Tuteku/Sistema-de-Monitoreo-de-CO-en-Tiempo-Real-con-LPC1769-ARM-Cortex-M3-/.mcuxpressoide_packages_support/readme.txt

This folder is automatically created and contains the SDK part support for the IDE
*** DO NOT REMOVE OR MODIFY, YOUR CHANGES WILL BE OVERWRITTEN ON SDK REFRESH ***
