Tuteku/Sistema-de-Monitoreo-de-CO-en-Tiempo-Real-con-LPC1769-ARM-Cortex-M3-/Grup_5_TPI_EDIII.pdf

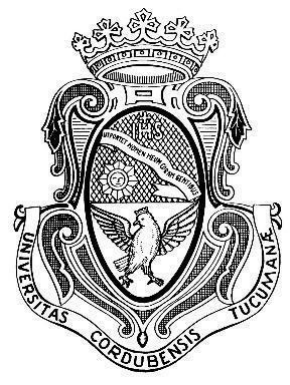
[picture p1: figure]

## UNIVERSIDAD NACIONAL DE CÓRDOBA

### FACULTAD DE CIENCIAS EXACTAS, FÍSICAS Y NATURALES

### CÁTEDRA DE ELECTRÓNICA DIGITAL III

## TRABAJO PRÁCTICO INTEGRADOR

## “SISTEMA DE DETECCIÓN DE ANOMALÍAS EN NIVELES DE MONÓXIDO DE CARBONO”

### Grupo Nº 5

### Alumnos: Costamagna, Matias

### de la Mata, Nicolas

### Quispe, Mateo

### Profesor:

### Migliore, Emiliano

### Comisión Nº 3

18/11/2025

### TABLA DE CONTENIDO

### 1. PROYECTO 2. DESCRIPCIÓN DEL SEP 3. DESARROLLO DE HARDWARE

CIRCUITO DEL SSEP MICROCONTROLADOR CIRCUITO DEL SSE DE SEÑALIZACIÓN ÓPTICA CIRCUITO DEL SSE DE SEÑALIZACIÓN ACÚSTICA CIRCUITO DEL SSE DE ADQUISICIÓN DE SEÑALES CIRCUITO DEL SSE DE COMUNICACIÓN DE DATOS CIRCUITO DEL SSE DE VISUALIZACIÓN DE DATOS

### 4. DESARROLLO DE FIRMWARE

FIRMWARE DEL SSE DE SEÑALIZACIÓN ÓPTICA FIRMWARE DEL SSE DE SEÑALIZACIÓN ACÚSTICA
FIRMWARE DEL SSE DE VISUALIZACIÓN DE DATOS
FIRMWARE DEL SSE DE ADQUISICIÓN DE SEÑALES
FIRMWARE DEL SSE DE COMUNICACIÓN DE DATOS

### 5. PRUEBAS DE SISTEMA 6. CONCLUSIONES 7. BIBLIOGRAFÍA Y REFERENCIAS 8. ANEXO

CIRCUITO ESQUEMÁTICO DEL SEP FIRMWARE DEL SEP LPC1769
FIRMWARE DEL SEP ESP8266
LISTA DE MATERIALES
HOJAS DE DATOS

### TÉRMINOS Y DEFINICIONES

TPI: Trabajo Práctico Integrador
SEP: Sistema Electrónico Programable SSE: Subsistema Electrónico
SSEP: Subsistema Electrónico Programable

### 1. PROYECTO

El presente Trabajo Práctico Integrador describe la implementación de un "SISTEMA DE DETECCIÓN DE ANOMALÍAS EN NIVELES DE MONÓXIDO DE CARBONO" destinado a la detección temprana y precisa de concentraciones peligrosas de monóxido de carbono (CO) en ambientes domésticos e industriales.

El sistema se basa en un LPC1769 como microcontrolador principal, el cual adquiere señales analógicas por medio de un sensor de gas MQ-7 especializado en la detección de monóxido de carbono para luego ser procesadas digitalmente. El resultado del análisis permite determinar la concentración de CO en el ambiente, expresada en PPM (partes por millón).

El sistema cuenta con múltiples interfaces de visualización y alerta: un sistema de señalización óptica mediante LEDs de colores que indican visualmente el nivel de peligro (verde: seguro, amarillo: precaución, rojo: peligro crítico), un sistema de señalización acústica mediante buzzer que genera alertas sonoras intermitentes en condiciones críticas, y una interfaz web accesible mediante WiFi a través del módulo ESP8266 que presenta los datos de concentración de CO en tiempo real.

La detección de monóxido de carbono se realiza mediante un sensor MQ-7, el cual posee alta sensibilidad al CO y baja sensibilidad a otros gases.

El sistema implementa además un mecanismo de confirmación de alarma crítica mediante la acumulación de múltiples lecturas consecutivas por encima del umbral, evitando falsas alarmas por picos momentáneos de concentración.

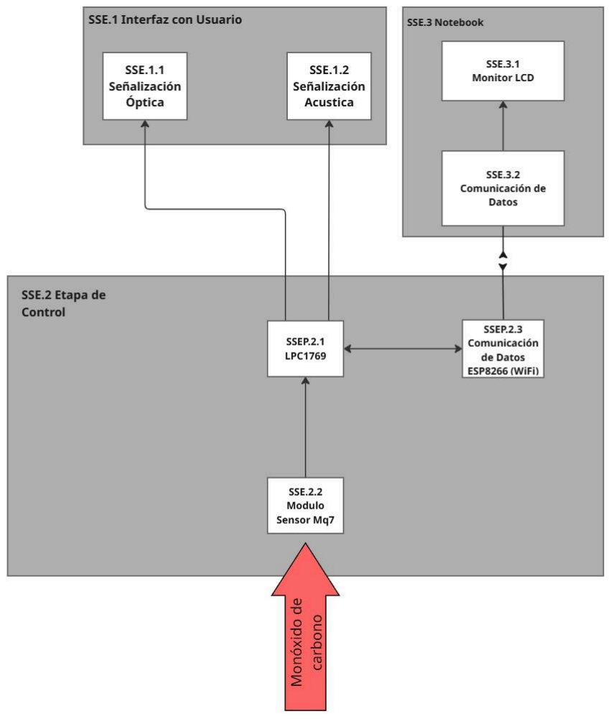
[picture p2: figure]

### 2.DESCRIPCIÓN DEL SEP

El sistema desarrollado consiste en un detector de monóxido de carbono automático basado en el microcontrolador LPC1769, diseñado para monitorear continuamente la concentración de CO en el ambiente mediante un sensor MQ-7. Cuando se detectan niveles peligrosos de gas, el sistema activa alarmas visuales y sonoras de forma progresiva según la gravedad de la situación.

El sistema opera de manera autónoma realizando mediciones periódicas cada 1 [s]. Las lecturas del sensor se procesan mediante el módulo ADC interno del LPC1769, convirtiendo las señales analógicas en valores digitales que representan la concentración de CO en [mV]. Estos valores se utilizan para determinar el estado de alerta del sistema según umbrales configurables: estado seguro (LED verde), estado de precaución (LED amarillo) y estado crítico (LED rojo con alarma sonora).

El usuario recibe información del sistema a través de múltiples interfaces: señalización óptica mediante tres LEDs de colores que indican el nivel de peligro, señalización acústica mediante un buzzer que se activa en situaciones críticas generando un tono de alerta, y transmisión de datos por comunicación serial UART hacia un módulo ESP8266 para visualización remota. Las señales adquiridas del sensor MQ-7 son procesadas por el ADC y distribuidas a los distintos subsistemas: control de alarmas, señalización óptica, señalización acústica y comunicación de datos.

El sistema implementa lógica de histéresis para evitar falsas alarmas, requiriendo múltiples lecturas consecutivas por encima del umbral de precaución antes de activar el estado crítico. Esta característica garantiza mayor confiabilidad en la detección, reduciendo activaciones espurias por variaciones momentáneas en la concentración de gas.

### 3. DESARROLLO DE HARDWARE

### 3.1. CIRCUITO DEL SSEP MICROCONTROLADOR

El subsistema electrónico programable central se basa en el microcontrolador LPC1769 de NXP, un dispositivo de 32 bits con arquitectura ARM Cortex-M3 que opera a una frecuencia de 100 [MHz]. Para el clock el sistema utiliza el oscilador RC interno del LPC1769 para generar la señal de reloj del sistema.

El microcontrolador utiliza los siguientes pines para interactuar con los distintos subsistemas:

- P0.23 (AD0.0): Entrada analógica para la lectura del sensor MQ-7, configurada con función alterna 1 para el canal 0 del ADC.
- P1.29 (MAT0.1): Salida del canal de Match 0 del Timer 0, configurada para generar los pulsos de disparo del ADC.
- P0.10 (TXD2): Transmisión UART2, para la comunicación serial con el módulo ESP8266.
- P0.2, P0.3, P0.27: Salidas GPIO configuradas para control de LEDs (rojo, amarillo y verde respectivamente).
- P0.22: Salida GPIO configurada para control del buzzer.

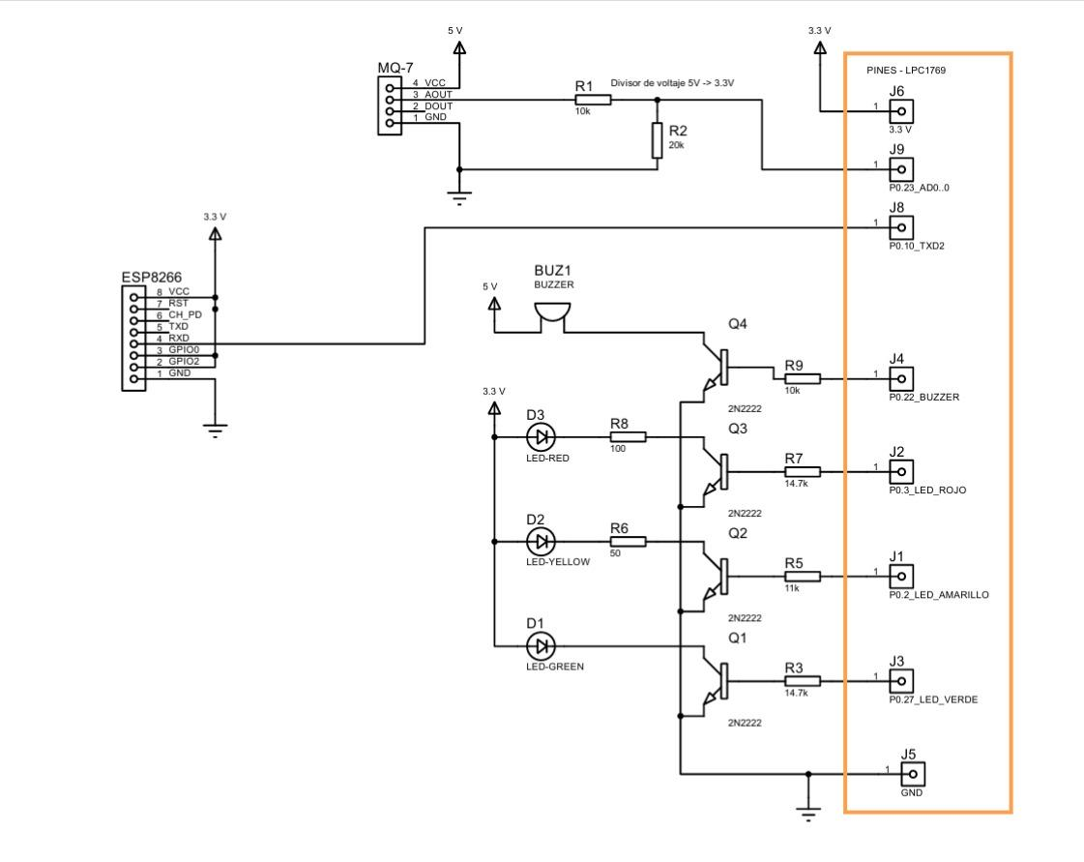
[picture p3: figure]

### 3.2. CIRCUITO DEL SSE DE SEÑALIZACIÓN ÓPTICA

El subsistema de señalización óptica proporciona retroalimentación visual inmediata al usuario sobre el estado de la concentración de monóxido de carbono detectada en el ambiente. Este subsistema utiliza tres LEDs de colores estándar (verde, amarillo y rojo) que indican de manera visual e intuitiva los diferentes niveles de alerta del sistema.

Componentes Utilizados:

- LED Verde D1 (P0.27): Indica estado seguro, con concentración de CO por debajo del umbral de precaución.
- LED Amarillo D2 (P0.3): Indica estado de precaución, con concentración de CO mayor al umbral de precaución.
- LED Rojo D3 (P0.2): Indica estado crítico, con concentración de CO por encima del umbral de precaución sostenida en el tiempo.

Dado que los pines GPIO del LPC1769 tienen una capacidad limitada de corriente (máximo 2.58 [mA] para el periférico GPIO), y considerando que los LEDs estándar requieren típicamente 15-20 [mA] para una luminosidad adecuada, se implementó un circuito mediante transistores NPN 2N2222A para cada LED.

R

LED R =

V

CC−V

LED R−V
CE(sat)
I
LED

=

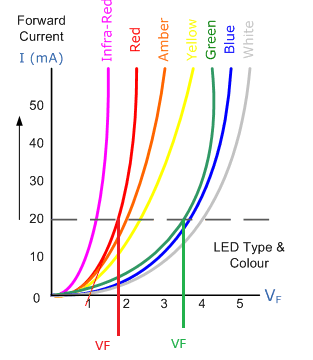
[picture p4: figure]

3.3 [V]−1.5 [V]−0.3 [V]
15 [mA] = 93. 33 [Ω] ≈ 100 [Ω]

R

LED V =

V

CC−V

LED V−V
CE(sat)
I
LED

=

3.3 [V]−3 [V]−0.3 [V]
15 [mA] = 0 [Ω] −> No es necesaria

R

LED A =

V

CC−V

LED A −V
CE(sat)
I
LED

=

3.3 [V]−2 [V]−0.3 [V]
15 [mA] = 66, 67 [Ω] ≈ 50 [Ω]

I

LED A =

V

CC−V

LED A−V
CE(sat)
R
LED A

=

3.3 [V]−2 [V]−0.3 [V]
50 [Ω] = 20 [mA]

R

base =

V

OH−V
BE
I
B

=

(V

DD−0.4 [V])−V
BE
I
C
/ β | =

(3.3 [V]−0.4 [V])−0.7 [V]
15 [mA] / 100 = 14. 67 [kΩ] ≈ 14. 7 [kΩ]

R

base LED A =

V

OH−V
BE
I
B

=

(V

DD−0.4 [V])−V
BE
I
C
/ β | =

(3.3 [V]−0.4 [V])−0.7 [V]
20 [mA] / 100 | = 11 [kΩ]
1. Alimentación de los LEDs: Los ánodos de todos los LEDs se conectan directamente a la línea de alimentación de 3.3 [V].
2. Resistencias limitadoras de corriente (R4, R6, R8): Los LEDs rojo y amarillo cuentan con una resistencia en serie de 100 [Ω] y 50 [Ω] respectivamente conectadas entre el cátodo de cada LED y el colector del transistor 2N2222A, . Estas resistencias limitan la corriente que circula por los LEDs.
3. Transistores (Q1, Q2, Q3): Se utilizan transistores NPN 2N2222A configurados como interruptores en configuración de emisor común. El colector de cada transistor se conecta al cátodo del LED correspondiente a través de la resistencia limitadora, mientras que el emisor se conecta directamente a tierra (GND).
4. Resistencias de base (R3, R5, R7): Cada transistor cuenta con una resistencia de base de 14.7 [kΩ] (11 [kΩ] para el LED amarillo) conectada entre el pin GPIO del microcontrolador y la base del transistor. Estas resistencias limitan la corriente de base y protegen el pin GPIO del microcontrolador.

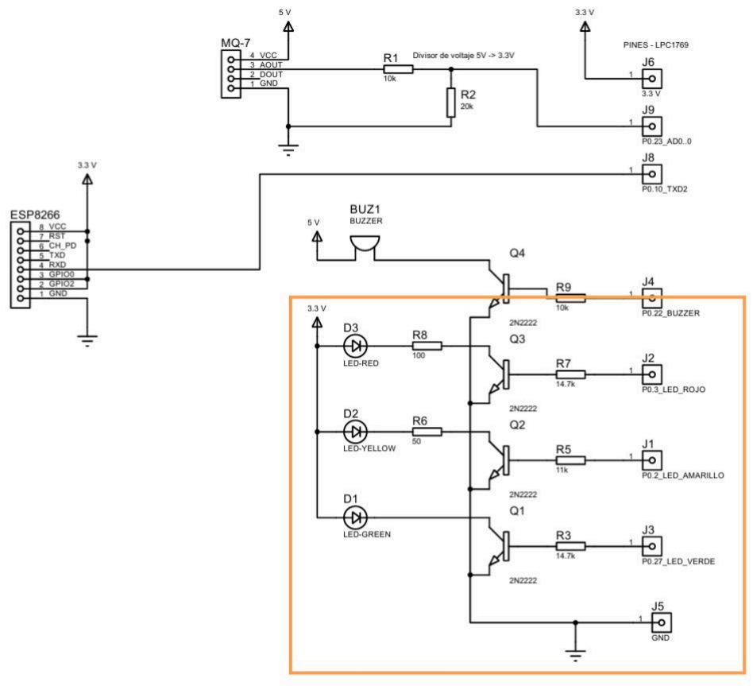
[picture p5: figure]

### 3.3. CIRCUITO DEL SSE DE SEÑALIZACIÓN ACÚSTICA

El subsistema de señalización acústica proporciona una alerta sonora cuando el sistema alcanza el estado crítico. Este subsistema complementa la señalización visual, generando una advertencia audible que permite al usuario ser alertado incluso cuando no está observando directamente los indicadores LED.

Componente Utilizado:

- Buzzer (P0.22): Transductor piezoeléctrico, o buzzer activo, que genera una señal sonora intermitente durante el estado de alarma crítica.

Circuito de Interfaz:

Similar al subsistema de señalización óptica, el buzzer requiere una tensión de alimentación que excede la tensión máxima de suministro del LPC1769 (3.3 [V]). Por esta razón, se implementó un circuito el cual se habilita mediante un transistor NPN 2N2222A que actúa como interruptor.

Datos:

- VCC = 5 [V]
- VBUZZER = 5 [V] (caída de voltaje típica del buzzer piezoeléctrico)
- VBE = 0.7 [V] (voltaje base-emisor del 2N2222A)
- VCE saturación = 0.4 [V]
- β = 100
- Corriente de consumo máximo del Buzzer = 30 [mA] = IC max

I

B max =

I
C max
β | = V OH−V
| BE
| R
| B min

R

B min = β ·

V

OH−V
BE
I
C

= 100 ·

(V

DD−0.4 [V] ) − 0.7 [V]
30 [mA] = 7. 33 [kΩ] −> Se elige 10 [kΩ]

Debido a que el buzzer genera una caída de tensión de 5V, es necesario alimentarlo con una fuente de tensión externa de ese valor. Además, resulta que no es necesario colocar una resistencia en el colector del transistor, pues la caída de tensión entre el colector y el emisor es menor que la VCE de saturación, lo que nos mantiene en esa zona de operación del transistor.

De esta forma, el buzzer se encenderá cada vez que la salida del pin conectado en la base se encuentre en un nivel lógico “1” generando así la caída de tensión necesaria entre la base y el emisor que habilite el paso de la corriente del colector, funcionando como un switch.

1. Alimentación del buzzer: El terminal positivo del buzzer se conecta directamente a la línea de alimentación de 5 [V].
2. Transistor (Q4): Transistor NPN 2N2222A configurado como interruptor. El colector se conecta al terminal negativo del buzzer, mientras que el emisor se conecta directamente a tierra (GND).
3. Resistencia de base (R9): Una resistencia de 10 [kΩ] conectada entre el pin P0.22 del microcontrolador y la base del transistor Q4. Esta resistencia limita la corriente de base a 0.22 [mA].

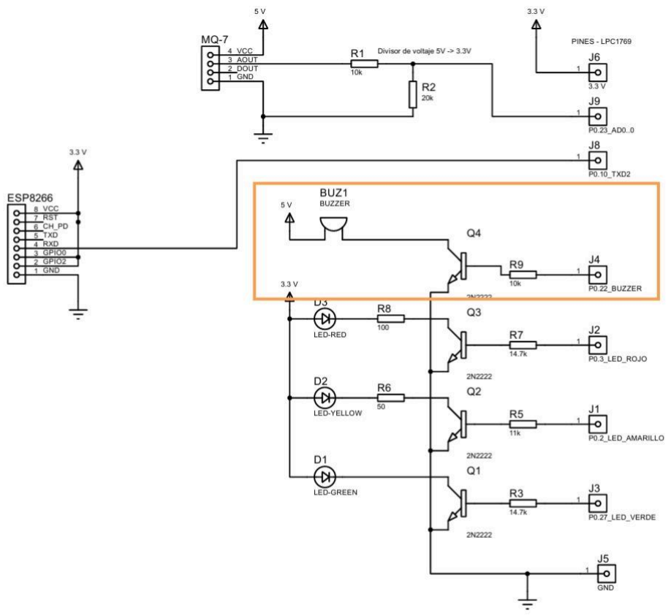
[picture p6: figure]

### 3.4. CIRCUITO DEL SSE DE ADQUISICIÓN DE SEÑALES

El subsistema de adquisición de señales es el componente sensorial del sistema, responsable de detectar la presencia y concentración de monóxido de carbono en el ambiente. Este subsistema utiliza el sensor de gas MQ-7, capaz de detectar concentraciones en el rango de 20 a 2000 [ppm]. El sensor MQ-7 requiere una alimentación de 5 [V] para su correcto funcionamiento. Esta tensión se obtiene directamente de la línea de 5 [V] del puerto USB de la computadora.

La salida analógica del sensor MQ-7 proporciona un voltaje proporcional a la concentración de CO detectada, con un rango típico de 0 a 5 [V]. Sin embargo, el conversor analógico-digital (ADC) del microcontrolador LPC1769 acepta señales de entrada con un rango dinámico comprendido entre 0 y 3.3 [V]. Aplicar voltajes superiores a 3.3 [V] en el pin del ADC podría dañar permanentemente el microcontrolador.

Para resolver esta incompatibilidad, se implementó un circuito divisor resistivo que escala proporcionalmente el voltaje de salida del sensor al rango aceptable por el ADC. El divisor está compuesto por dos resistencias:

V

OUT = V
IN

·

R
2
R

1+R
2

= 5 [V] ·

20[kΩ]
10[kΩ]+20[kΩ] = 3. 3[V]
- R1 = 10 [kΩ]: Resistencia conectada entre la salida del sensor y el pin P0.23 (AD0.0) del microcontrolador.
- R2 = 20 [kΩ]: Resistencia conectada entre el pin P0.23 (AD0.0) y tierra (GND).

La señal acondicionada se conecta al pin P0.23 del microcontrolador LPC1769, configurado como entrada analógica (AD0.0), correspondiente al canal 0 del conversor analógico-digital.

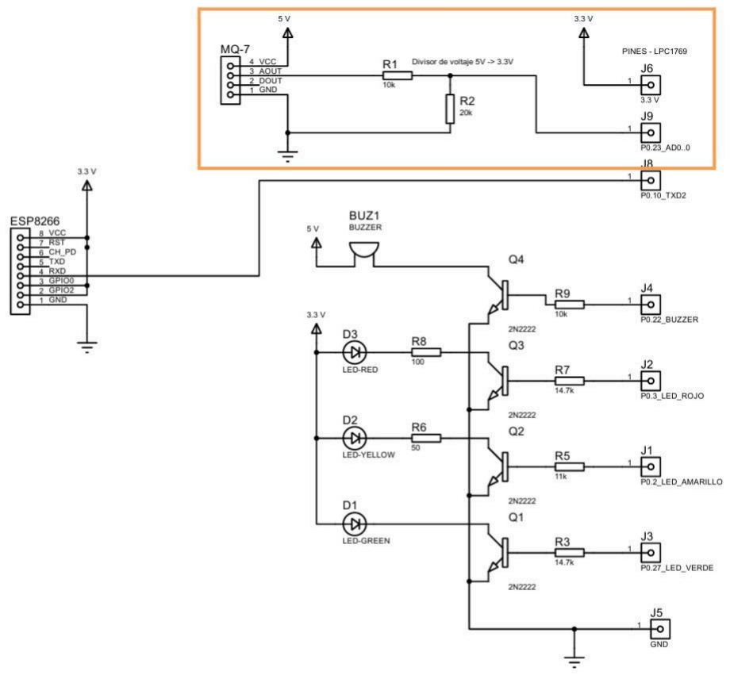
[picture p7: figure]

Calibración del Sensor MQ-7

La calibración del sensor MQ-7 se realizó utilizando la curva característica proporcionada en la hoja de datos del fabricante, que relaciona la razón (Rs/Ro) con la concentración de monóxido de carbono en partes por millón (PPM).

Rs es el valor de la resistencia en presencia de la concentración actual de la sustancia mientras que Ro es el valor de resistencia del sensor en presencia de una concentración de 100 [ppm] de CO.

A partir de los puntos de la curva característica, se construyó una tabla de valores PPM en función de la relación Rs/Ro y se graficaron los datos para identificar el comportamiento del sensor. Mediante ajuste de curvas, se determinó que la relación entre la razón Rs/Ro y la concentración de CO es la siguiente:

Concentración [PPM] = 100 · (

R
s
R
o

)

−1.52

Esta ecuación permite convertir directamente las lecturas de resistencia del sensor en valores de concentración de CO. El valor de Ro lo obtuvimos midiendo en una zona sin presencia de CO agregado, fue de 72.41 [kΩ].

El valor de tensión entregado por el circuito de acondicionamiento es el valor de la caída de tensión producida sobre una resistencia de carga RL, que en nuestro caso es de 47 [kΩ].

En el firmware, la resistencia del sensor Rs se calcula a partir del voltaje que ingresa por el pin del ADC.

La fórmula que permite calcular la resistencia viene dada por la siguiente expresión:

R
S
R
L

=

(V

C−VRL)
VRL

R

S = R
L

·

(V

C−VRL)
VRL

Una vez estimado el valor de Rs, se obtiene la relación con respecto a Ro y ese resultado se ingresa en la fórmula que calcula la concentración a partir de la relación entre Rs y Ro.

La | implementación | de | esta | conversión | se encuentra en la función
convert_adc_to_ppm() y es la que permite que el sistema determine en tiempo real la concentración de CO en el ambiente con precisión suficiente para activar las alarmas según los umbrales configurados.

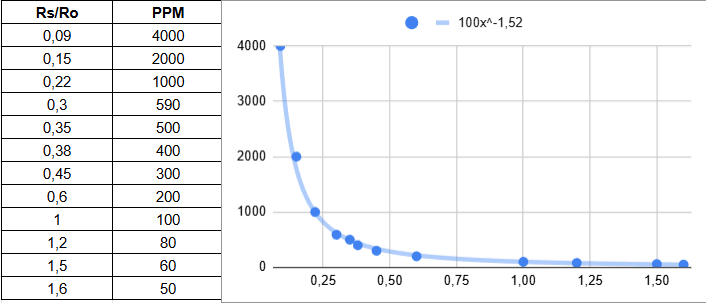
[picture p8: figure]

Esquemático del módulo MQ-7:

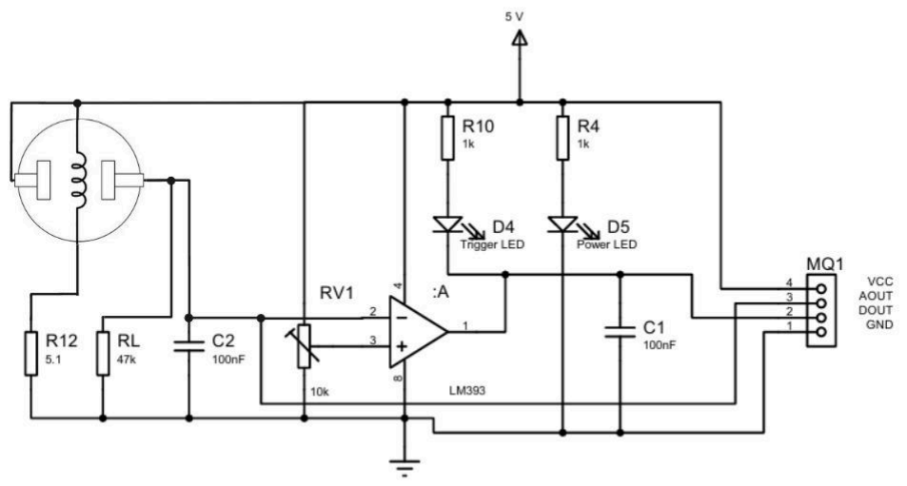
[picture p9: figure]

### 3.5. CIRCUITO DEL SSE DE COMUNICACIÓN DE DATOS

El subsistema de comunicación de datos desde la placa a la PC se realiza en 2 tramos: El LPC1769 envía la información al módulo ESP8266 utilizando comunicación serial UART; el ESP8266 funciona como puente de red, reenviando los respectivos datos hacia la PC del usuario a través de una conexión WiFi.

Para implementar esta comunicación, el sistema utiliza el periférico UART2 del microcontrolador. La UART es un protocolo de comunicación serial asíncrono que no requiere señal de reloj compartida entre transmisor y receptor, simplificando las conexiones de hardware.

El sistema implementa un esquema de transmisión alternada controlado por el Timer 2, que gestiona dos modos de operación:

- Modo de transmisión en tiempo real: Transmite datos instantáneos cada 1 [s] durante un período de 10 [s]. En este modo, se envían las lecturas individuales del sensor mediante tramas tipo 'U'.
- Modo de transmisión de promedios: Activo durante 3 [s], en el cual se transmite el promedio de las últimas 10 muestras capturadas mediante tramas tipo 'P'. Durante este período, el sistema utiliza el DMA para transferir las muestras almacenadas a un buffer secundario y a partir de allí calcular el promedio.

El Timer 2 alterna automáticamente entre estos dos modos, proporcionando al usuario tanto información instantánea como datos estadísticos promediados que permiten una evaluación más precisa de la concentración de CO en el ambiente.

Los parámetros de configuración de la UART2 son:

- Velocidad de transmisión (Baud Rate): 9600 bps, velocidad estándar que garantiza comunicación confiable.
- Bits de datos: 8 bits por carácter (configuración estándar).
- Bit de paridad: Ninguno.
- Bits de parada: 1 bit (configuración estándar).
- Control de flujo: Ninguno, la comunicación es unidireccional desde el LPC1769 hacia el ESP8266.

Para la conexión se utiliza únicamente la línea de transmisión (TX) del UART2 por medio del pin P0.10. Este pin se conecta directamente al pin RX (receptor) del módulo ESP8266.

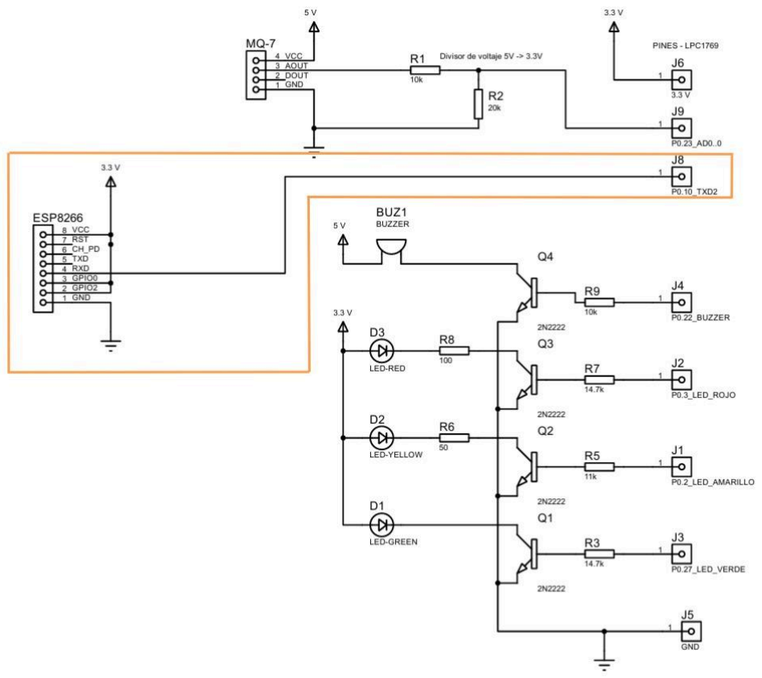
[picture p10: figure]

### 3.6. CIRCUITO DEL SSE DE VISUALIZACIÓN DE DATOS

El subsistema de visualización de datos proporciona al usuario acceso remoto a la información de concentración de monóxido de carbono detectada por el sistema. Se implementa una solución de visualización basada en conectividad WiFi mediante el módulo ESP8266, permitiendo el monitoreo desde cualquier dispositivo con navegador web dentro de la red local.Componentes del Subsistema:

Módulo ESP8266:

- Actúa como servidor web que aloja la interfaz de usuario
- Recibe datos del LPC1769 a través de UART2 a 9600 bps
- Proporciona conectividad WiFi
- Alimentación: 3.3V (compatible con niveles lógicos del LPC1769)

Protocolo de Comunicación:

El LPC1769 envía tramas de datos al ESP8266 mediante comunicación serial con el siguiente formato:

- Trama tipo 'U': Datos instantáneos - U<valor ppm>\n
- Ejemplo: U15\n indica 15 [ppm] de CO detectado en la última lectura individual
- Se transmite cada 1 [s] durante los períodos de 10 [s] en modo tiempo real

- Trama tipo 'P': Datos promediados - P<valor_ppm>\n
- Ejemplo: P12\n indica 12 [ppm] de CO como promedio de 10 muestras
- Se transmite durante los períodos de 3 [s] en modo promedio
- El cálculo del promedio se realiza mediante transferencia DMA de las muestras almacenadas

El sistema alterna automáticamente entre el envío de datos instantáneos (10 [s]) y datos promediados (3 [s]), permitiendo al usuario visualizar tanto la evolución inmediata como las tendencias estadísticas de la concentración de CO.

Interfaz Web:

El subsistema de visualización presenta una interfaz web HTML alojada en el ESP8266 que muestra:

- Concentración actual de CO en [ppm]: Valor numérico actualizado en tiempo real
- Gráfico temporal: Representación visual de la evolución de la concentración de CO
- Indicador de estado: Representación visual del nivel de alarma (seguro/precaución/crítico)
- Tipo de medición: Indicación de la última medición instantánea y el último promedio obtenido

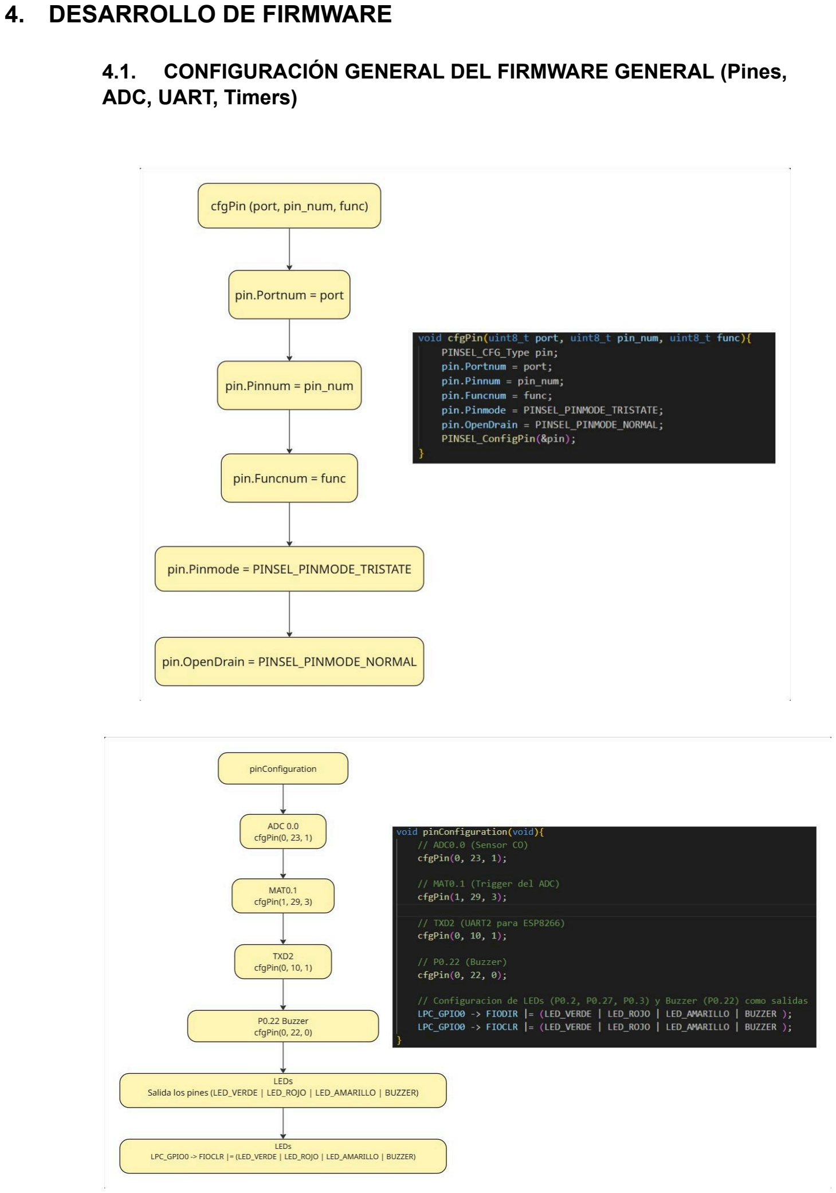
[picture p11: page 15]

### 4. DESARROLLO DE FIRMWARE

4.1. CONFIGURACIÓN GENERAL DEL FIRMWARE GENERAL (Pines, ADC, UART, Timers)

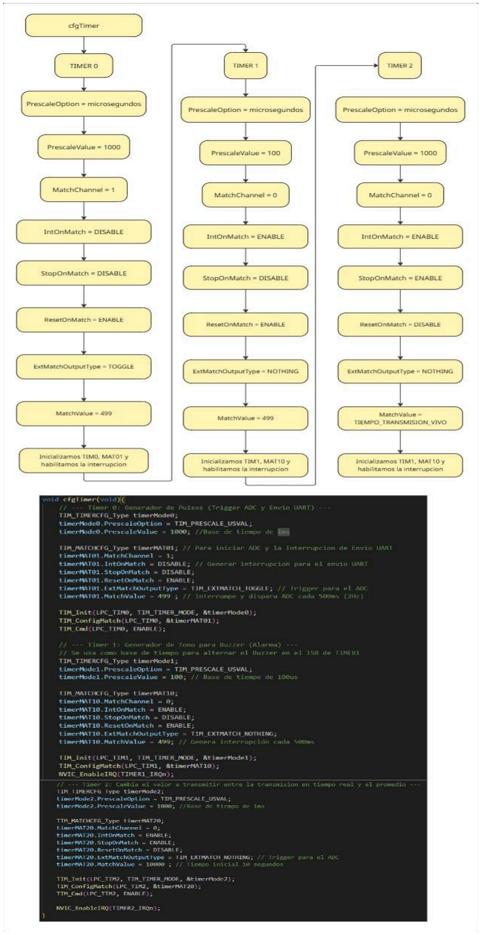
[picture p12: figure]
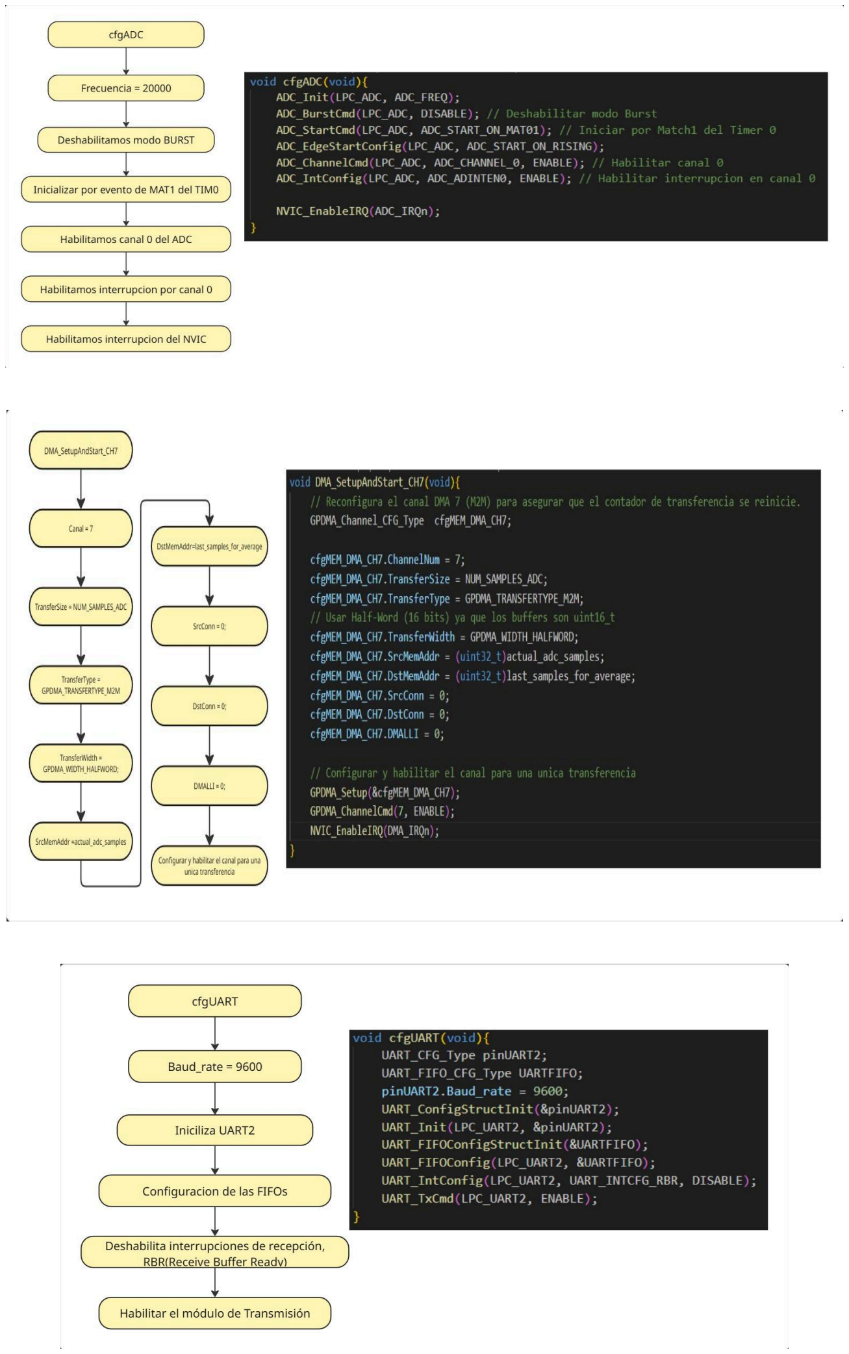
[picture p13: page 17]
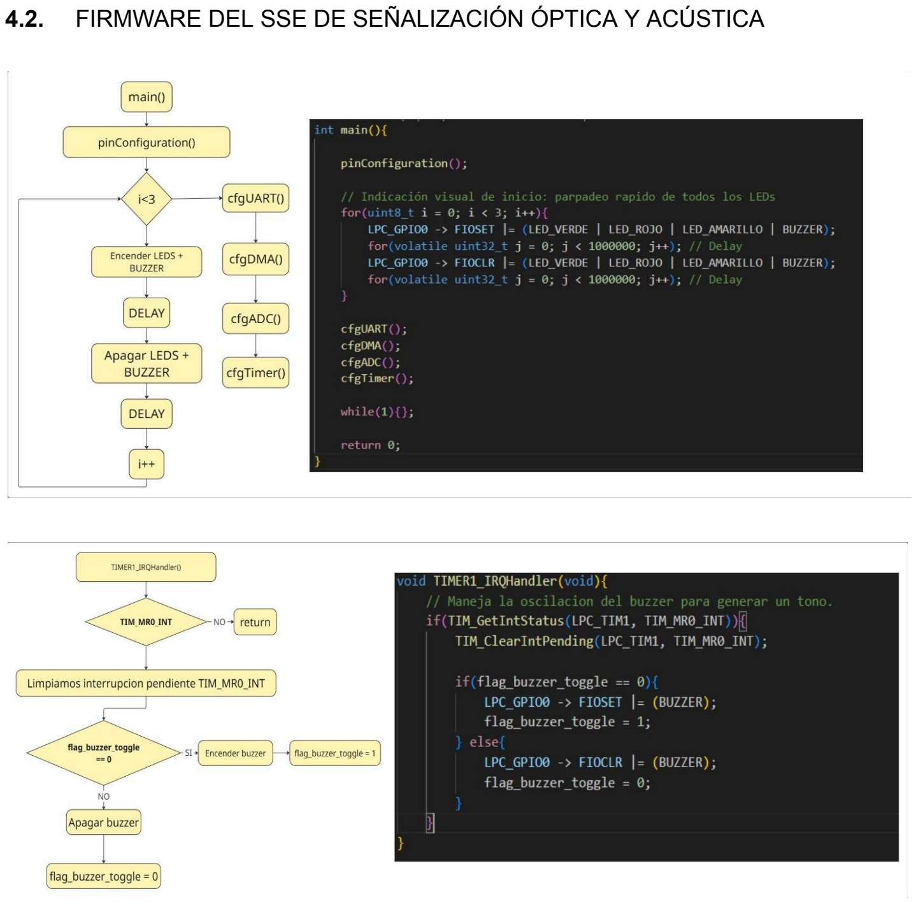
[picture p14: page 18]

### 4.2. FIRMWARE DEL SSE DE SEÑALIZACIÓN ÓPTICA Y ACÚSTICA

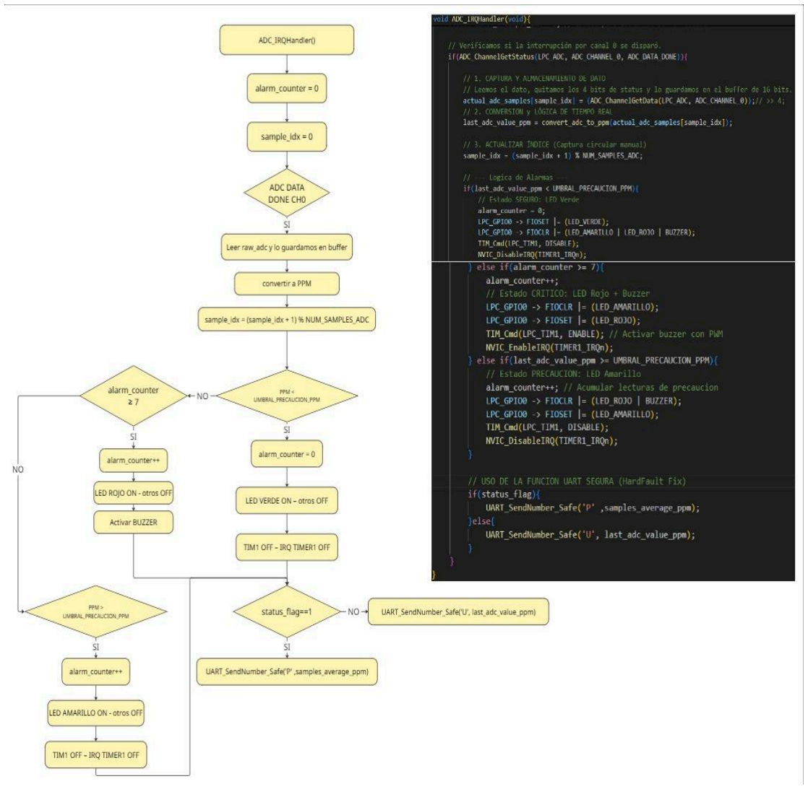
[picture p15: figure]
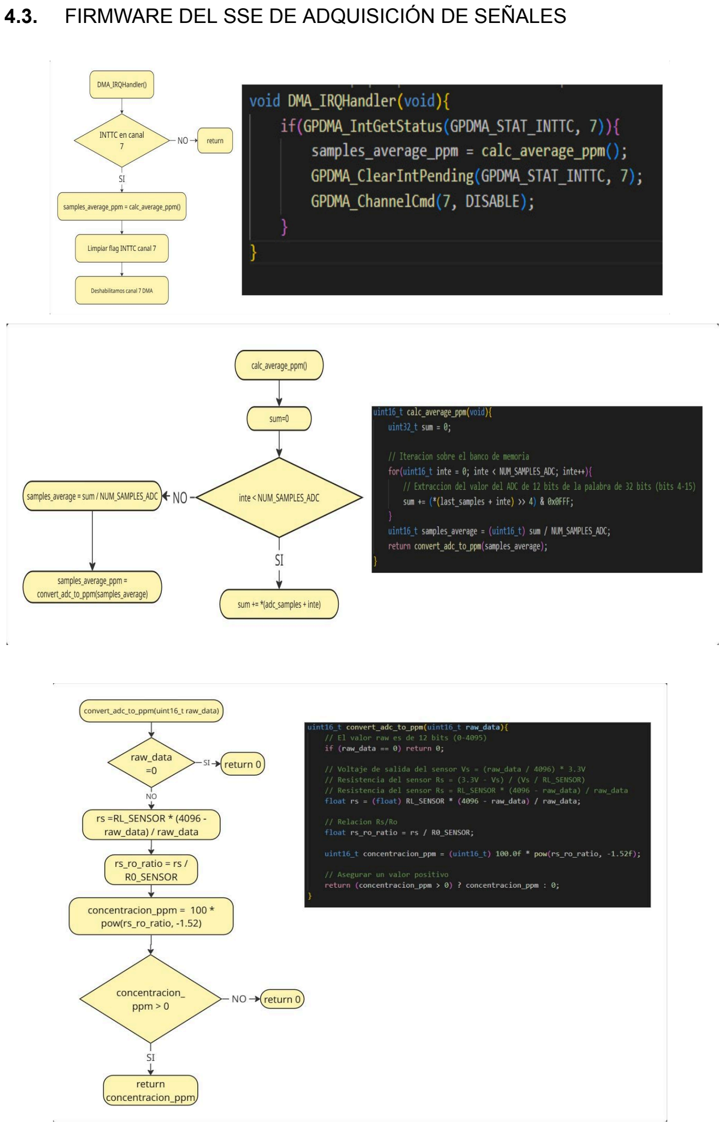
[picture p16: page 20]

### 4.3. FIRMWARE DEL SSE DE ADQUISICIÓN DE SEÑALES

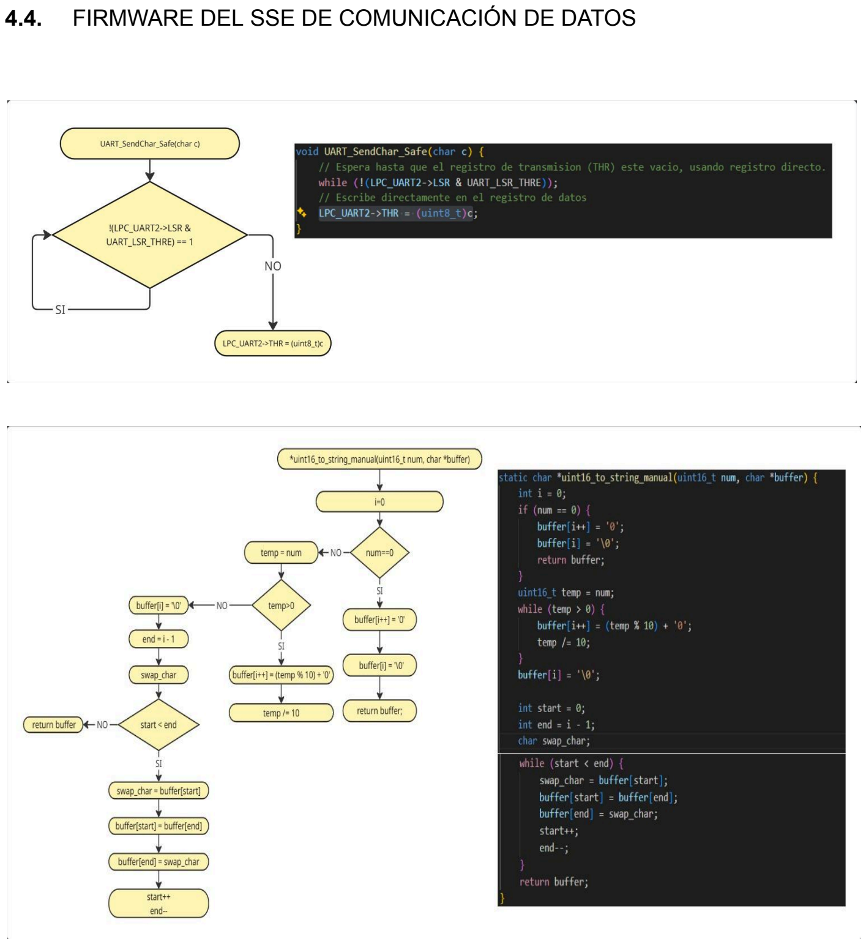
[picture p17: page 21]

### 4.4. FIRMWARE DEL SSE DE COMUNICACIÓN DE DATOS

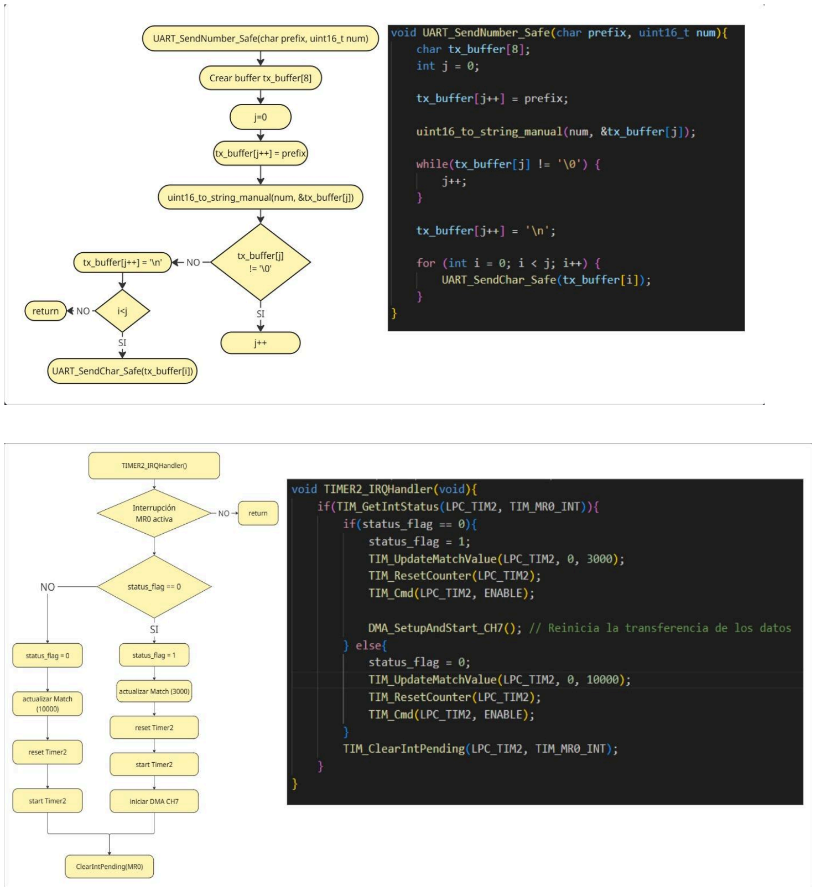
[picture p18: page 22]

### 5. PRUEBAS

Nro. Caso de Prueba | Descripción del Caso de Prueba | Paso | Resultado Esperado | Resultado Obtenido | Observaciones
1 | Pruebas de Señalización Visual (LEDs) | Mantener sensor en aire limpio (<25 [ppm]) | LED verde encendido, LED amarillo y rojo apagados | PASO | Valor estable de concentración obtenido 2 [ppm]
2 | Pruebas de Señalización Acústica (Buzzer) | Simular concentración crítica (> 25 [ppm] por 10 lecturas) | Buzzer genera tono intermitente (~2 [Hz]) | PASO | Distinción notable en la intermitencia del buzzer
3 | Pruebas de Comunicación UART | Capturar datos UART en monitor serial a 9600 [bps] | Distinción de cada tipo de trama (“U” o “P”) | PASO | Se distingue correctamente el tipo de trama en su correspondiente periodo
4 | Pruebas de Lógica de Sistema | Generar 6 lecturas > UMBRAL SEGURO seguidas | Sistema en precaución, NO activa alarma crítica | PASO | Se alterna correctamente entre el estado seguro y de precaución, según corresponda la lectura, sin alcanzar el estado de alarma
5 | Pruebas de Interfaz Web (ESP8266) | Encender ESP8266 y verificar conexión | Página de resultados visible | PASO | Pequeña demora en la visibilidad de los datos debido a la conexión del módulo WiFi con la red

### 6. CONCLUSIONES

Este TPI logró implementar exitosamente un sistema funcional de detección de monóxido de carbono, cumpliendo con los objetivos planteados mediante la integración de los módulos principales del LPC1769. Destacamos como aprendizajes significativos la implementación de lógica de histéresis para evitar falsas alarmas y la calibración del sensor analógico.

La idea sobre la cual se desarrolló el trabajo, tiene como foco el monitoreo de gas en dispositivos emisores del mismo, de forma tal de poder detectar fugas no deseadas que puedan resultar riesgosas para la salud. Por lo tanto, como primera mejora a realizar, se considera un actuador que pudiese regular el paso de monóxido de carbono del emisor, para que llegado al caso de estar en una situación de alerta, el sistema pueda cerrar el paso de forma autónoma.

### 7. BIBLIOGRAFÍA

### 1. HIGIENE Y SEGURIDAD EN EL TRABAJO. Resolución 295/2003. Recuperado

de
https://www.argentina.gob.ar/normativa/nacional/resoluci%C3%B3n-295-2003-90396/texto (https://www.argentina.gob.ar/normativa/nacional/resoluci%C3%B3n-295-2003-90396/texto)

### 2. Centers for Disease Control and Prevention. NIOSH Pocket Guide to Chemical

Hazards – Carbon monoxide. Recuperado de https://www.cdc.gov/niosh/npg/npgd0105.html

### 3. How to Use the MQ-7 Carbon Monoxide Sensor. Recuperado de

https://www.teachmemicro.com/use-mq-7-carbon-monoxide-sensor/

### 4. LPC1769 USER MANUAL. Recuperado de

https://drive.google.com/file/d/1BxeQVesQgAabMhWhEc_bcC6LzO5qRXpJ/view?usp=drive_link (https://drive.google.com/file/d/1BxeQVesQgAabMhWhEc_bcC6LzO5qRXpJ/view?usp=drive_link)

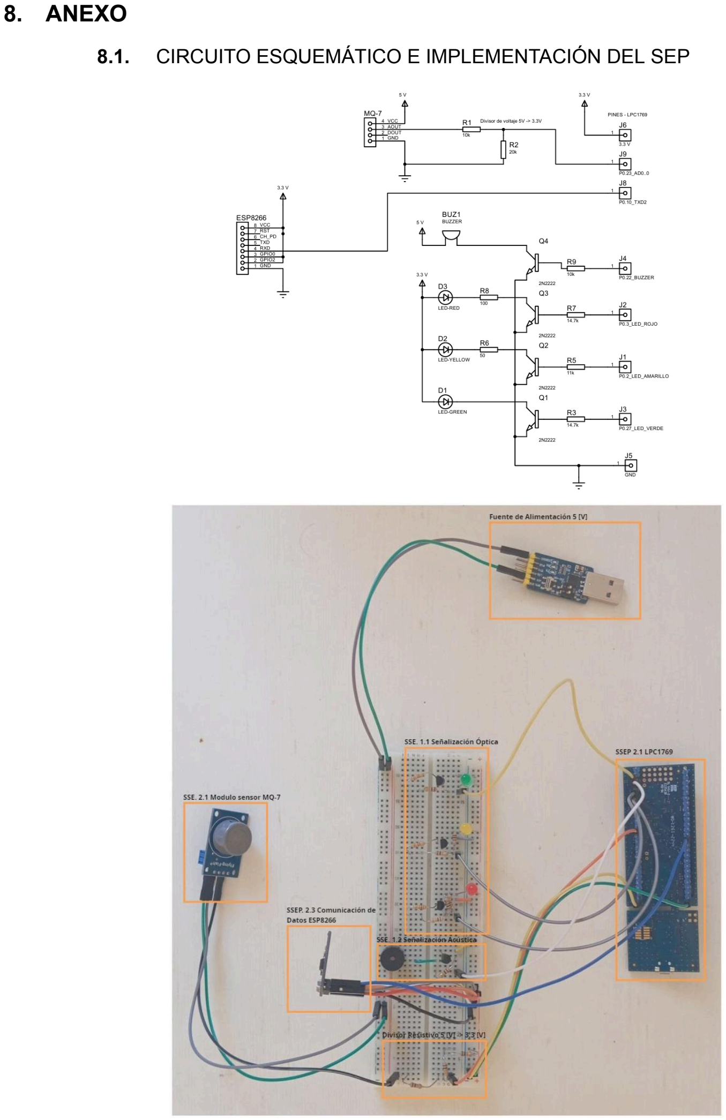
[picture p19: page 25]

### 8. ANEXO

### 8.1. CIRCUITO ESQUEMÁTICO E IMPLEMENTACIÓN DEL SEP

### 8.2. FIRMWARE DEL SSEP LPC1769

FIRMWARE LPC1769 (https://drive.google.com/file/d/1HJRHjg_zi6wBVGd5JkfsoAOVntlsf8l8/view?usp=drive_link)

### 8.3. FIRMWARE DEL SSEP ESP8266

FIRMARE ESP8266 (https://drive.google.com/file/d/1i_gBXUxP86fl_fdulc61fscDGOiItVBj/view?usp=drive_link)

### 8.4. HOJAS DE DATOS

MQ-7 (https://drive.google.com/file/d/14qynIVBK3etX2Di1lU_Nq9J22aIH-V2V/view?usp=sharing)

ESP-01 (https://drive.google.com/file/d/1uN4I3SWFVqhkXLipxrGIyU2DfnFXtS-P/view?usp=sharing)

LPC1769 (https://drive.google.com/file/d/1iI5Z3KvF2AKxXfdccW--VIS-UXxr6aLm/view?usp=sharing)

BUZZER (https://drive.google.com/file/d/1E6_kC2KCrTN_VPYz56sTMipe2LNpTTay/view?usp=sharing)

2N2222A (https://drive.google.com/file/d/1IQpkl5jy0UC7ZRpq2abo65SmP0KVS9rV/view?usp=sharing)
