Tuteku/Sistema-de-Monitoreo-de-CO-en-Tiempo-Real-con-LPC1769-ARM-Cortex-M3-/(list of files, drawings)

Other design files:
TP Final ED3.pdsprj
