Tuteku/Sistema-de-Monitoreo-de-CO-en-Tiempo-Real-con-LPC1769-ARM-Cortex-M3-/(commit log)

2025-11-04 Initializing rep
    [TP Final ED3.pdsprj]
2025-11-10 ADC, Timer y Pines funcionando
2025-11-10 Archivo para ESP01
2025-11-10 UART y pagina web funcionando, falta calibrar sensor y ajustar umbrales
2025-11-12 Calibracion sensor y ajuste de umbrales criticos
2025-11-14 Agregado DMA M2M y configuracion de interrupcion externa
2025-11-14 Modificacion en la ecuacion y agregado DMA M2M
2025-11-16 modificacion logica para cambio de valor a mostrar
2025-11-16 Guardado de version para modificar UART
2025-11-16 Calculo de promedio correcto, falta corregir los parametros del sensor
    [main.c]
